adafruit/Adafruit-Joy-Featherwing-PCB/Joypad FeatherWing rev C.brd

## EAGLE design Joypad FeatherWing rev C.brd (2017-10-02)

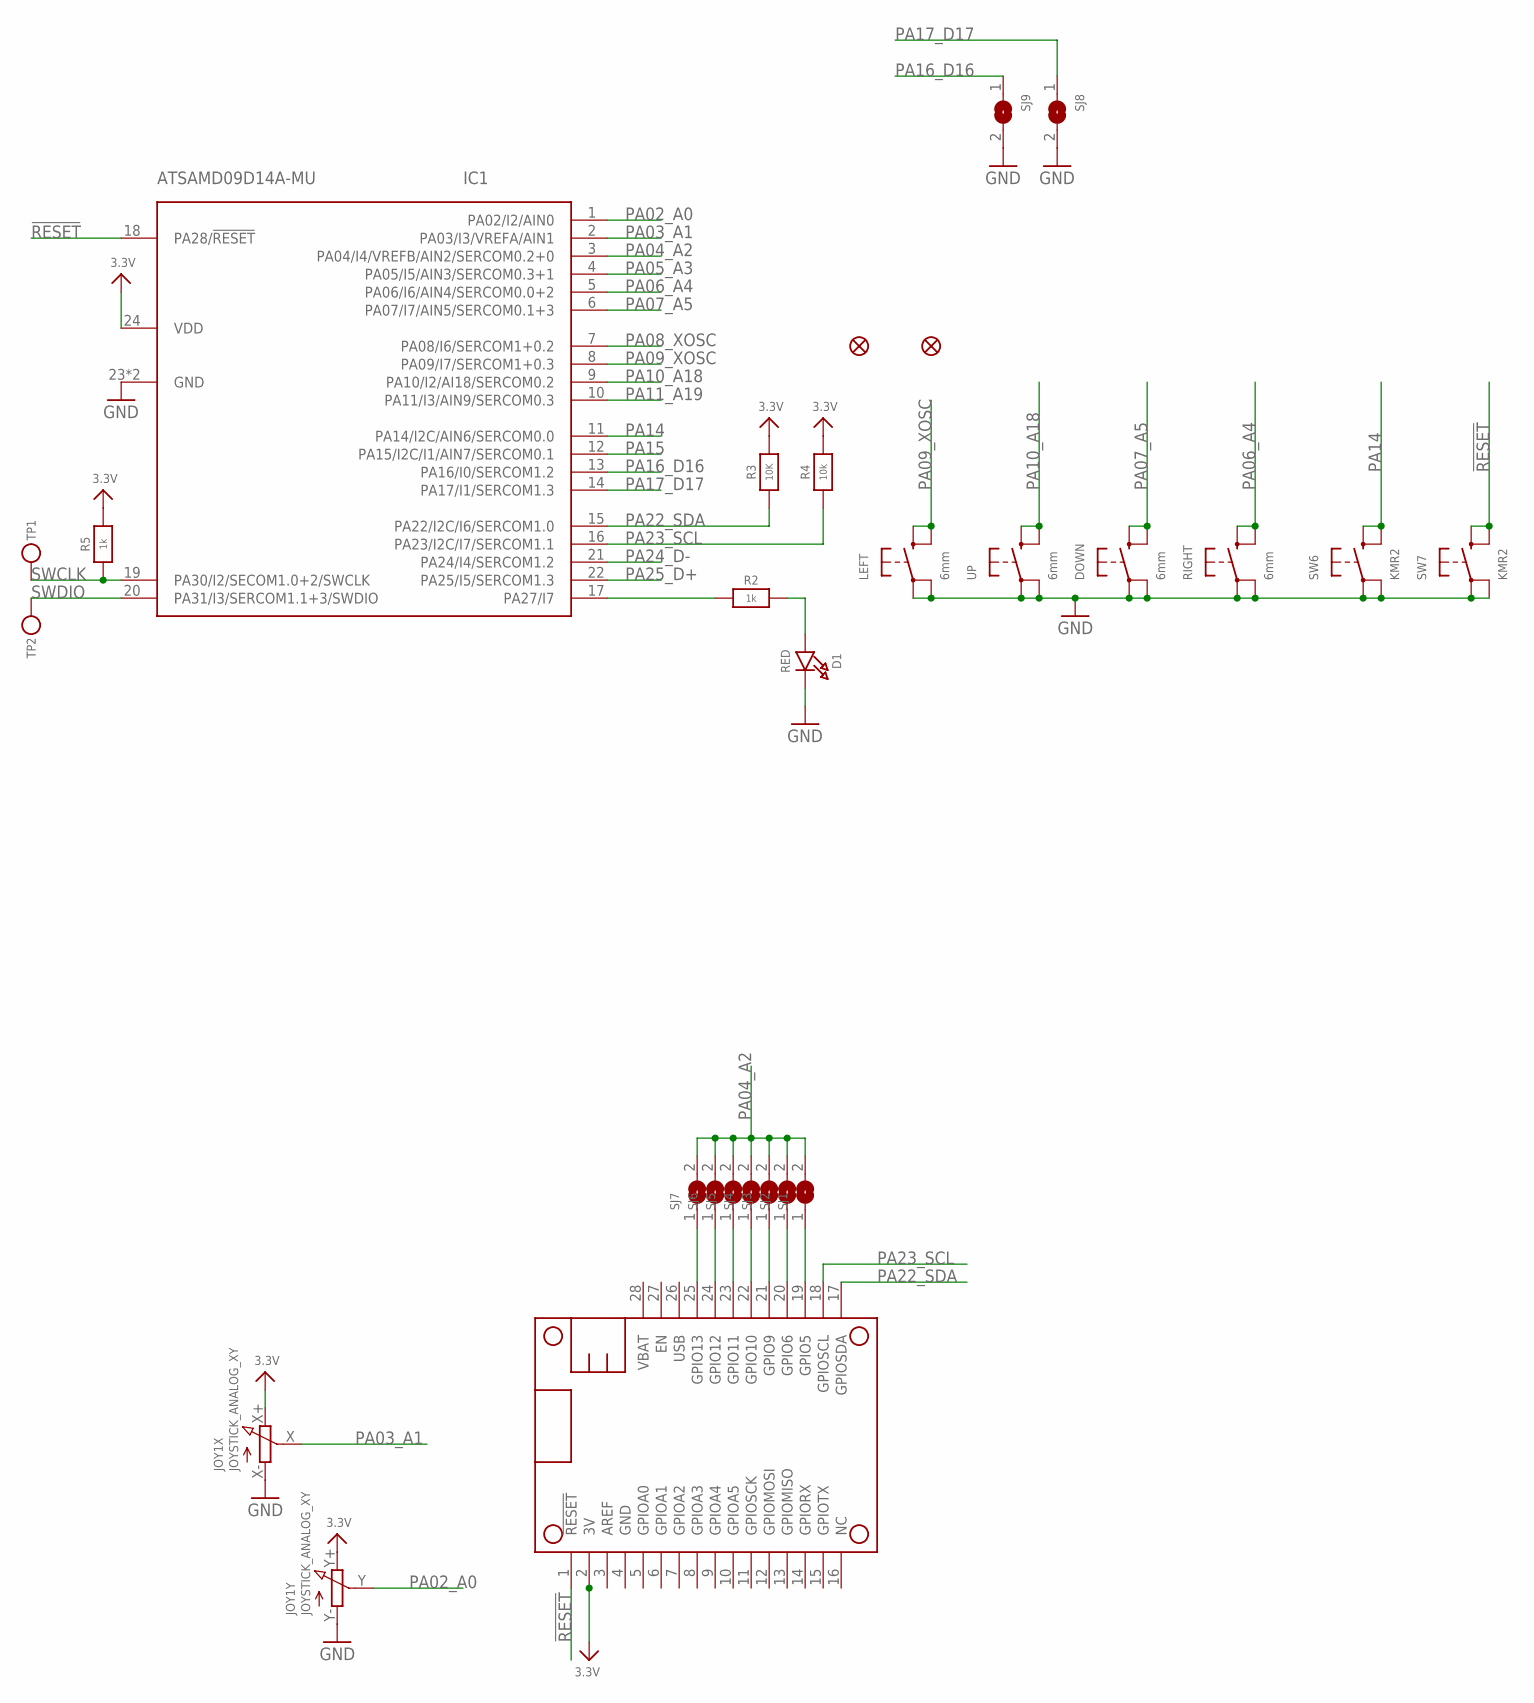
[picture p2: schematic Joypad FeatherWing rev C.sch]

Parts:
D1: RED; CHIPLED_0805_NOOUTLINE
DOWN: 6mm; EVQ-Q2_SMALLER
FID1, FID2: FIDUCIAL_1MM
IC1: ATSAMD09D14A-MU; QFN24_4MM
JOY1: JOYSTICK_ANALOG_XY; JOYSTICK_ANALOG_MINITHM
LEFT: 6mm; EVQ-Q2_SMALLER
MS1: FEATHERWING
R2, R5: 1k; 0603-NO
R3: 10K; 0603-NO
R4: 10k; 0603-NO
RIGHT: 6mm; EVQ-Q2_SMALLER
SJ1, SJ2, SJ3, SJ4, SJ5, SJ6, SJ7, SJ8, SJ9: SOLDERJUMPER; SOLDERJUMPER_ARROW_NOPASTE
SW6, SW7: KMR2; BTN_KMR2_4.6X2.8
TP1, TP2: TESTPOINTROUND2MM; TESTPOINT_ROUND_2MM
UP: 6mm; EVQ-Q2_SMALLER

Connections:
3.3V: IC1.24 (VDD), JOY1.X+ (E), JOY1.Y+ (E), MS1.2 (3V), R3.2, R4.2, R5.2
!RESET: IC1.18 (PA28/!RESET), MS1.1 (!RESET), SW7.B (S), SW7.B' (S1)
GND: D1.C, DOWN.A, DOWN.A' (P1), IC1.23 (GND), IC1.THERM (GND), JOY1.X- (A), JOY1.Y- (A), LEFT.A, LEFT.A' (P1), MS1.4 (GND), RIGHT.A, RIGHT.A' (P1), SJ8.2, SJ9.2, SW6.A, SW6.A' (P1), SW7.A, SW7.A' (P1), UP.A, UP.A' (P1)
unnamed: MS1.19 (GPIO5), SJ1.1
unnamed: MS1.20 (GPIO6), SJ2.1
unnamed: MS1.21 (GPIO9), SJ3.1
unnamed: MS1.22 (GPIO10), SJ4.1
unnamed: IC1.17 (PA27/I7), R2.1
unnamed: MS1.23 (GPIO11), SJ5.1
unnamed: MS1.24 (GPIO12), SJ6.1
unnamed: MS1.25 (GPIO13), SJ7.1
unnamed: D1.A, R2.2
PA02_A0: IC1.1 (PA02/I2/AIN0), JOY1.Y (S)
PA03_A1: IC1.2 (PA03/I3/VREFA/AIN1), JOY1.X (S)
PA04_A2: IC1.3 (PA04/I4/VREFB/AIN2/SERCOM0.2+0), SJ1.2, SJ2.2, SJ3.2, SJ4.2, SJ5.2, SJ6.2, SJ7.2
PA05_A3: IC1.4 (PA05/I5/AIN3/SERCOM0.3+1)
PA06_A4: IC1.5 (PA06/I6/AIN4/SERCOM0.0+2), RIGHT.B (S), RIGHT.B' (S1)
PA07_A5: DOWN.B (S), DOWN.B' (S1), IC1.6 (PA07/I7/AIN5/SERCOM0.1+3)
PA08_XOSC: IC1.7 (PA08/I6/SERCOM1+0.2)
PA09_XOSC: IC1.8 (PA09/I7/SERCOM1+0.3), LEFT.B (S), LEFT.B' (S1)
PA10_A18: IC1.9 (PA10/I2/AI18/SERCOM0.2), UP.B (S), UP.B' (S1)
PA11_A19: IC1.10 (PA11/I3/AIN9/SERCOM0.3)
PA14: IC1.11 (PA14/I2C/AIN6/SERCOM0.0), SW6.B (S), SW6.B' (S1)
PA15: IC1.12 (PA15/I2C/I1/AIN7/SERCOM0.1)
PA16_D16: IC1.13 (PA16/I0/SERCOM1.2), SJ9.1
PA17_D17: IC1.14 (PA17/I1/SERCOM1.3), SJ8.1
PA22_SDA: IC1.15 (PA22/I2C/I6/SERCOM1.0), MS1.17 (GPIOSDA), R3.1
PA23_SCL: IC1.16 (PA23/I2C/I7/SERCOM1.1), MS1.18 (GPIOSCL), R4.1
PA24_D-: IC1.21 (PA24/I4/SERCOM1.2)
PA25_D+: IC1.22 (PA25/I5/SERCOM1.3)
SWCLK: IC1.19 (PA30/I2/SECOM1.0+2/SWCLK), R5.1, TP1.P$1
SWDIO: IC1.20 (PA31/I3/SERCOM1.1+3/SWDIO), TP2.P$1

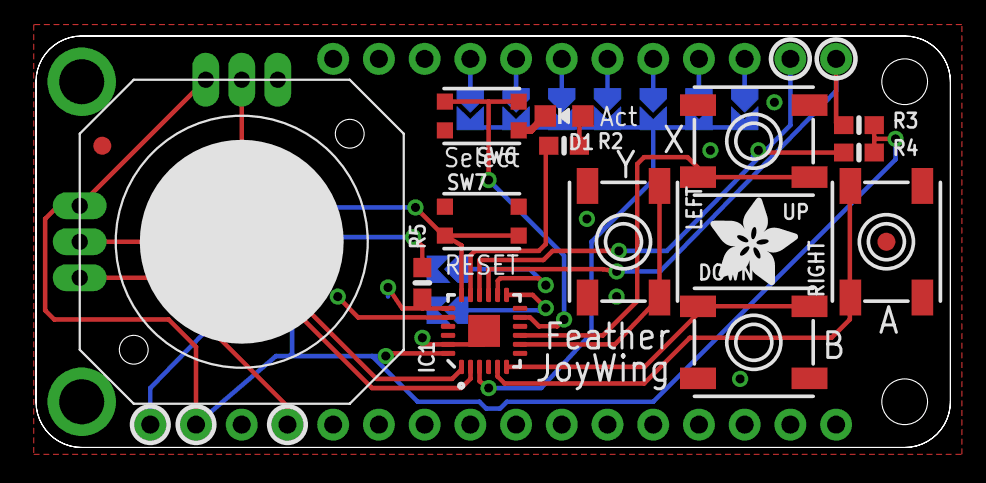
[picture p3: board Joypad FeatherWing rev C.brd from above]

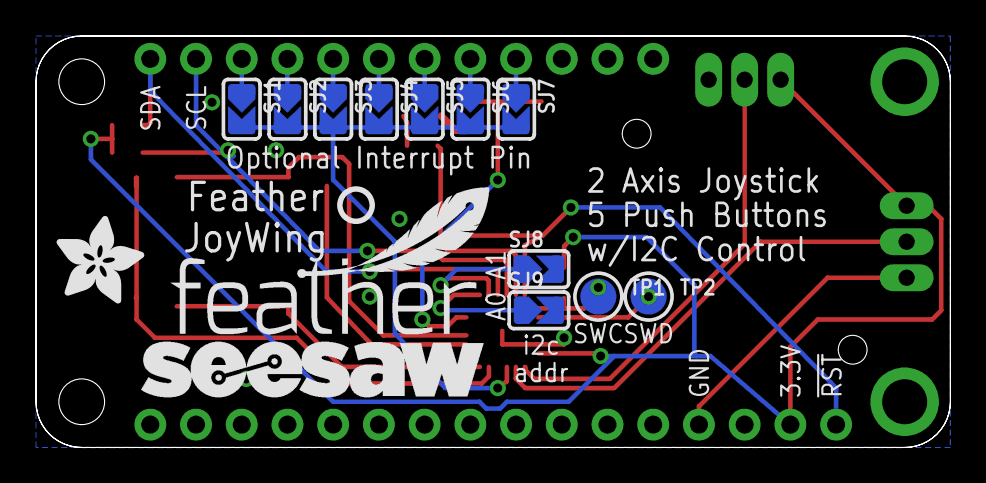
[picture p4: board Joypad FeatherWing rev C.brd from below]

Board: 2 copper layers, 50.8 x 22.9 mm, 32 parts (15 on the bottom side), 26 nets.

Other parts of the board:
U$7: PCBFEAT-REV-040
U$9, U$11: ADAFRUIT_5MM
U$10: FEATHERLOGO_MED
U$12: SEESAW_LOGO
